imsalmankhalid/CNC_Project/hat_v1/hat3.png

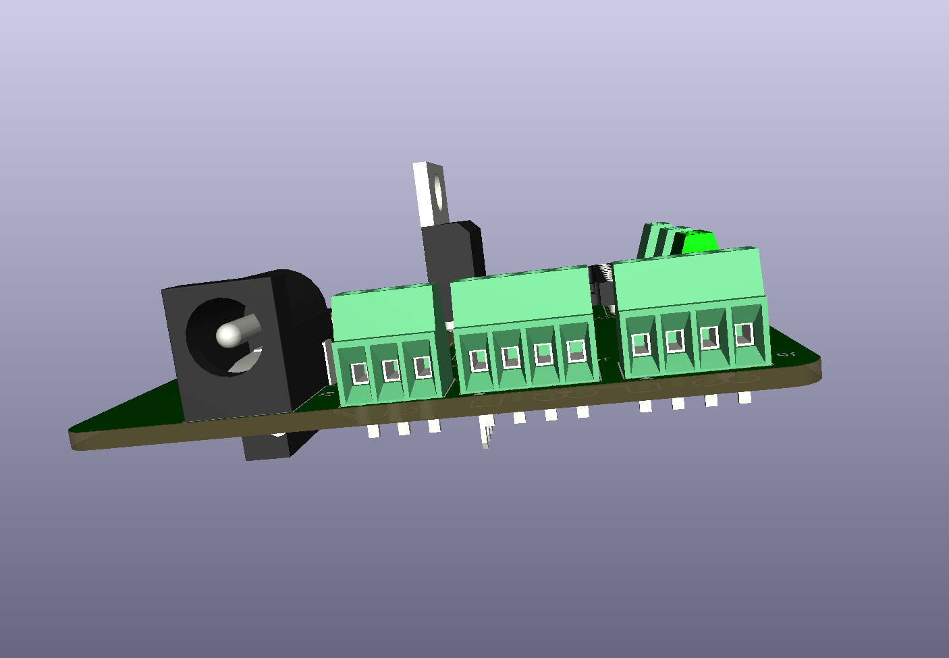
hat_v1/hat3.png
