imsalmankhalid/CNC_Project/hat_v1/hat2.png

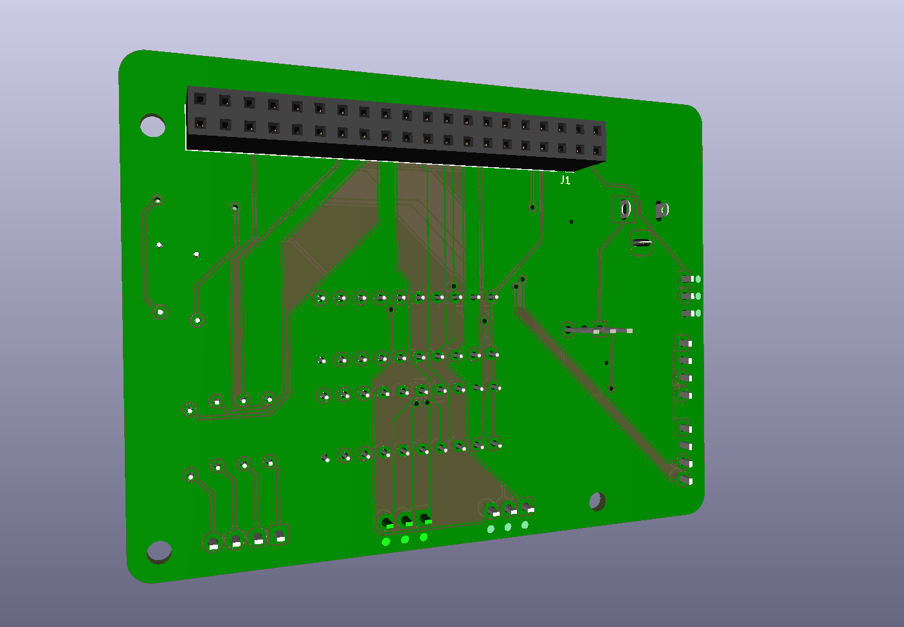
hat_v1/hat2.png
