imsalmankhalid/CNC_Project/lathe_rpi/MP2307DN_Schematic.html

# MP2307DN – 12V to 5V Fixed Buck Regulator

Complete pin-by-pin schematic with all external components · SOP-8 package · 3A output

VIN_12V (12V)

SW (switch node)

5V0_BUCK (5V out)

GND

3V3 (enable)

BOOT

RT/CT → GND

FB → GND (fixed 5V)

VIN 12V Input

3V3 Enable Source

C1 10µF 16V

U3 MP2307DN-5.0 SOP-8

Pin 1 VIN← VIN_12V

Pin 2 EN← 3V3 via R7

Pin 3 SW→ SW node

Pin 4 GND→ GND

Pin 5 BOOT→ C11 → SW

Pin 6 RT/CT→ R24 → GND

Pin 7 FB→ GND (fixed)

Pin 8 GND→ GND

R7 100kΩ

L1 10µH Shielded

D9 SS34 Schottky (SMA)

C11 100nF

R24 22kΩ

C9 22µF 16V

C10 100nF 16V

OUT 5V

📋 External Components (7 total)
L1 10µH shielded inductor (6030 SMD)
D9 SS34 Schottky diode (SMA)
C1 10µF 16V input cap (0805)
C9 22µF 16V output cap (1206)
C10 100nF 16V output decoupling (0805)
C11 100nF bootstrap cap (0805)
R7 100kΩ EN pull-up (0805)
R24 22kΩ frequency-set (0805)

⚡ Key Specifications
Input: 4.75V – 23V (12V nominal)
Output: 5.0V fixed (±1%)
Max current: 3.0A
Frequency: ~550kHz (R24=22kΩ)
Efficiency: ~88% at 12V→5V/2A
Quiescent current: 1.2mA
Shutdown current: 0.1µA (EN=GND)

🔧 Pin Function Notes
VIN — Unregulated 12V input (after fuse)
EN — Enable: HIGH=on, LOW=shutdown. Tie to 3V3 via 100kΩ.
SW — Switch node: connects to inductor. NOISY — keep trace short!
BOOT — Bootstrap: 100nF cap between BOOT and SW.
RT/CT — Timing resistor to GND sets switching frequency.
FB — Feedback: tied to GND for fixed 5V output.
GND — Pins 4 & 8: connect to solid GND plane.

Wire Colors

12V Input

SW / BOOT

5V Output

3V3 Enable

GND
