imsalmankhalid/CNC_Project/lathe_rpi/PCB_Full_Schematic.html

# MbW Lathe HAT – Full Schematic with Wired Connections

## Net Connection Table

Net Name | Color | Connected Components | Pin Count
3V3 | #3fb950 | U2(9 AVDD), R11(2), R4(2), R10(2), R18(2), U2(5 DVDD), U3(2 EN), R12(2), R17(2), R22(2), R1(2), R3(2), J3(1 VCC), D14(Cathode), D15(Cathode), R23(2), R14(2), C6(+), R2(2), C2(1), C3(1), R15(2), J2(1 VCC), C4(+), R16(2) | 25
3V3_REG | #7ee787 | C14(1), D14(Anode), U4(4 VOUT), C13(+) | 4
3V3_RPi | #3fb950 | D15(Anode) | 1
5V0 | #f0883e | U1(11 DIR), C5(+), D11(Cathode), C1(1), J6(1 5V), J4(6 5V), D12(Cathode), U1(20 VCC), J7(1), J5(6 5V) | 10
5V0_BUCK | #ffa657 | D11(Anode), C9(+), C10(1), L1(2), D9(Cathode) | 5
5V0_RPi | #f0883e | D12(Anode) | 1
BOOT_5V | #ffa657 | C11(1), U3(5 BOOT) | 2
BTN1_IN | #79c0ff | R10(1), J8(1) | 2
BTN2_IN | #79c0ff | R11(1), J9(1) | 2
BTN3_IN | #79c0ff | R12(1), J10(1) | 2
ESTOP_COM | #8b949e | J16(3 COM) | 1
ESTOP_IN | #79c0ff | R20(2), J16(2 NO), R18(1), LED2(Anode), R20(1) | 5
ESTOP_NC | #f0883e | J16(1 NC) | 1
HALF_NUT_IN | #79c0ff | J11(1), R13(1) | 2
I2C_SCL | #d2a8ff | U2(2 SCL), R23(1) | 2
I2C_SDA | #d2a8ff | U2(1 SDA), R22(1) | 2
LIM_X_MINUS_IN | #79c0ff | J15(1), R17(1) | 2
LIM_X_PLUS_IN | #79c0ff | R16(1), J14(1) | 2
LIM_Z_MINUS_IN | #79c0ff | R15(1), J13(1) | 2
LIM_Z_PLUS_IN | #79c0ff | R14(1), J12(1) | 2
POT_WIPER | #79c0ff | J7(2), R9(1) | 2
POT_WIPER_ADC | #79c0ff | U2(7 AIN0), R9(2) | 2
RT_CT | #8b949e | U3(6 RT/CT), R24(1) | 2
SPINDLE_IN | #79c0ff | R8(1), R7(2) | 2
SPINDLE_RAW | #79c0ff | J6(3 RAW), D7(Signal), R7(1) | 3
SW_5V | #ffa657 | C11(2), L1(1), U3(3 SW), D9(Anode) | 4
VIN_12V | #ff7b72 | C12(+), U4(1 VIN), C7(+), C1(+), R19(1), R19(2), F1(2), D13(Anode), D8(Cathode), C8(1), U3(1 VIN), LED1(Anode) | 12
VIN_12V_RAW | #ff7b72 | J17(Center), D13(Cathode), F1(1) | 3
X_DIR_3V3 | #58a6ff | U1(5 A5) | 1
X_DIR_5V | #58a6ff | J5(2 DIR), U1(16 B5), D5(Signal) | 3
X_ENC_A_IN | #79c0ff | J3(3 A), R3(1) | 2
X_ENC_B_IN | #79c0ff | J3(4 B), R4(1) | 2
X_EN_3V3 | #58a6ff | U1(6 A6) | 1
X_EN_5V | #58a6ff | U1(17 B6), J5(3 EN), D6(Signal) | 3
X_STEP_3V3 | #58a6ff | U1(4 A4) | 1
X_STEP_5V | #58a6ff | U1(15 B4), D4(Signal), R6(1) | 3
X_STEP_SERVO | #58a6ff | J5(1 STEP), R6(2) | 2
Z_DIR_3V3 | #58a6ff | U1(2 A2) | 1
Z_DIR_5V | #58a6ff | J4(2 DIR), D2(Signal), U1(13 B2) | 3
Z_ENC_A_IN | #79c0ff | R1(1), J2(3 A) | 2
Z_ENC_B_IN | #79c0ff | R2(1), J2(4 B) | 2
Z_EN_3V3 | #58a6ff | U1(3 A3) | 1
Z_EN_5V | #58a6ff | J4(3 EN), U1(14 B3), D3(Signal) | 3
Z_STEP_3V3 | #58a6ff | U1(1 A1) | 1
Z_STEP_5V | #58a6ff | R21(1), LED3(Anode), R5(1), D1(Signal), U1(12 B1), R21(2) | 6
Z_STEP_SERVO | #58a6ff | J4(1 STEP), R5(2) | 2

## Design Suggestions & Improvements ### ✅ Already Correct in Current Design 1. **I2C: NO capacitors on SDA/SCL** — This is correct. The 4.7kΩ pull-ups are sufficient. - ADS1015 adds ~5pF input capacitance per line - Short traces (<5cm) add ~100pF trace capacitance - Total bus capacitance well within 400pF I2C spec limit - **Adding caps would SLOW rise time and cause I2C errors at 400kHz** 2. **Decoupling capacitors** — Every IC has 100nF within 2mm of power pins ✓ 3. **Bulk capacitors** — Each power rail has 10µF bulk cap ✓ 4. **Regulator caps** — Per datasheet requirements ✓ ### 🔧 Suggested Improvements #### 1. I2C Ferrite Bead (Recommended for Industrial Environment) - **Add**: FB1 = 600Ω ferrite bead (0805) on I2C_SDA between RPi and ADS1015 - **Why**: Lathe environment has motor noise. Ferrite bead filters high-frequency noise without slowing I2C. - **Placement**: Between R22 (pull-up) and ADS1015 SDA pin - **Part**: Murata BLM21PG601SN1D (600Ω @ 100MHz, 0805) - **Cap after bead**: C15 = 22pF from filtered SDA to GND (absorbs HF noise) - **Same for SCL**: FB2 + C16 = 22pF #### 2. Encoder Input Protection (Recommended) - **Add**: TVS diodes on encoder lines (Z_ENC_A/B, X_ENC_A/B) - **Why**: Encoder cables run through noisy lathe environment - **Part**: PESD5V0S1UL (same as servo signals) - **Designators**: D16-D19 (one per encoder line) #### 3. Power Rail Ferrite Beads (Optional) - **Add**: FB3 on 5V0 rail near servo connectors (filters motor noise from feeding back) - **Add**: FB4 on 3V3 rail near ADC (cleaner analog supply) - **Part**: Murata BLM21PG121SN1D (120Ω @ 100MHz) #### 4. Spindle Signal Schmitt Trigger (Recommended) - **Add**: 74HC14 Schmitt trigger on SPINDLE_IN line - **Why**: Spindle index signal may have slow rise time from voltage divider - **Alternative**: Add RC filter (100Ω + 100pF) before GPIO pin #### 5. E-Stop NC Trace Width (Critical) - **Current**: ESTOP_NC trace breaks servo ENABLE - **Suggestion**: Use 2mm wide trace for ESTOP_NC path (mechanical reliability) - **Add**: Red silkscreen overlay on ESTOP_NC trace for visual inspection #### 6. Ground Plane Stitching - **Add**: Via every 10mm around board perimeter (connects top/bottom GND) - **Add**: Via near every decoupling capacitor (low-indistance GND return) #### 7. Test Points (Recommended for Debugging) - **Add**: TP1 = 5V0 rail, TP2 = 3V3 rail, TP3 = VIN_12V - **Add**: TP4 = I2C_SDA, TP5 = I2C_SCL (for oscilloscope probing) - **Part**: TestPad_SMD:TestPad_1.0x1.0mm #### 8. Boot/Configuration Jumpers (Optional) - **Add**: JP1 = I2C pull-up enable/disable (for debugging with external pull-ups) - **Add**: JP2 = Encoder pull-up enable/disable #### 9. Thermal Relief for SOT-223 (AP2112) - **Current**: Thermal pad connected to GND - **Suggestion**: Use thermal relief pads (not solid connection) for easier soldering - **Via count**: 3 vias under thermal pad to inner GND plane #### 10. Component Orientation Markers - **Add**: Pin 1 indicator dots on all IC footprints - **Add**: Diode cathode band markers (white silkscreen line) - **Add**: LED polarity markers (+/-) ### ⚠️ Things to Verify Before Fabrication 1. **MP2307 EN pin**: Currently tied to 3V3. Verify this works when 12V is absent (RPi back-feeds 3V3). - If 3V3 rail is powered by RPi back-feed, EN will be HIGH → buck tries to start → but no 12V input → no harm, just idle. - **Safe**: Buck won't output without VIN, so this is fine. 2. **74HC245 3.3V input threshold**: V_IH_min = 0.6 × 5V = 3.0V. RPi outputs 3.3V. - **Margin**: Only 0.3V above threshold. Works in practice but tight. - **Alternative**: Use 74HCT245 (T-series, V_IH = 2.0V at 5V) for better margin. - **Recommendation**: Stick with 74HC245 (already validated in Arduino design). If issues arise, switch to 74HCT245. 3. **Diode OR-ing power loss**: SS34 forward drop ~0.3V at typical current. - 5V rail: 5.0V - 0.3V = 4.7V at load (still within 5V tolerance) - 3.3V rail: 3.3V - 0.3V = 3.0V at load (within 3.3V ±5% = 3.135V minimum) - **WARNING**: 3.0V is BELOW 3.3V -5% tolerance! Consider using lower-drop Schottky (MBR0520T, Vf=0.2V) or ideal diode controller. - **Mitigation**: If using 12V always, this is fine (buck/LDO outputs are clean). Only matters in USB-C-only mode. 4. **Capacitor voltage ratings**: Verify all caps have adequate voltage rating. - C13 (10µF on 3V3_REG): 6.3V rating → OK (3.3V < 6.3V) - C9 (22µF on 5V0_BUCK): 16V rating → OK (5V < 16V) - C7 (10µF on VIN_12V): 25V rating → OK (12V < 25V) 5. **Inductor current rating**: L1 (10µH) should handle MP2307 peak current (~3.5A). - Verify inductor saturation current > 3.5A (Taiyo Yuden GQH101010T: 2.1A saturation) - **POTENTIAL ISSUE**: GQH101010T may saturate at high load. Consider COILCRAFT SSD1050 (3.2A sat) or similar.
