imsalmankhalid/CNC_Project/lathe_rpi/PCB_Full_Schematic_Clean.html

# MbW Lathe HAT – Complete Schematic

12V DC jack + RPi native USB-C · 74HC245 level shifting · ADS1015 ADC · All components placed with wired connections

⚡ Power Input & Protection

🔋 MP2307 Buck 12V→5V

🔋 AP2112 LDO 12V→3.3V

🔗 Diode OR-ing

🔄 74HC245 Level Shifter

📊 ADS1015 ADC + I2C

🔌 Servo Connectors

📡 Encoders

⚙ Spindle Index

🔘 Buttons, Limits, E-Stop

J17 DC Jack 12V

Tip12V

SleeveGND

F1 1A Fuse

D8 TVS

C7 10µF

C8 100nF

U3 MP2307DN Buck

1 VINVIN_12V

2 EN3V3

3 SWSW

4,8 GNDGND

5 BOOTBOOT

6 RT22kΩ→GND

7 FBGND

L1 10µH

D9 SS34

C9 22µF

C10 100nF

C11 100nF

R24 22kΩ

U4 AP2112K-3.3 LDO

1 VINVIN_12V

2,3 GNDGND

4 VOUT3V3_REG

C12 10µF

C13 10µF

C14 100nF

D11 SS34 Buck→5V0

D12 SS34 RPi→5V0

D14 SS34 LDO→3V3

D15 SS34 RPi→3V3

C5 10µF

C6 10µF

U1 74HC245PW Level Shifter (A→B)

1 A1Z_STEP_3V312 B1Z_STEP_5V

2 A2Z_DIR_3V313 B2Z_DIR_5V

3 A3Z_EN_3V314 B3Z_EN_5V

4 A4X_STEP_3V315 B4X_STEP_5V

5 A5X_DIR_3V316 B5X_DIR_5V

6 A6X_EN_3V317 B6X_EN_5V

9 GNDGND20 VCC5V0

10 /CEGND11 DIR5V0

C1 100nF

R5 100Ω

R6 100Ω

J4 Z Servo (Molex-8)

1STEP

2DIR

3EN

5GND

65V0

J5 X Servo (Molex-8)

1STEP

2DIR

3EN

5GND

65V0

D1 TVS

D2 TVS

D3 TVS

D4 TVS

D5 TVS

D6 TVS

U2 ADS1015 ADC

1 SDAI2C_SDA

2 SCLI2C_SCL

3 A0GND

4 GNDGND

5 DVDD3V3

7 AIN0POT

9 AVDD3V3

R22 4.7kΩ

R23 4.7kΩ

C2 100nF

C3 100nF

C4 10µF

R9 10kΩ

J7 Pot (JST-3)

15V0

2Wiper

3GND

J2 Z Encoder (JST-6)

13V3

2GND

3A → GPIO5

4B → GPIO6

J3 X Encoder (JST-6)

13V3

2GND

3A → GPIO13

4B → GPIO19

R1 10kΩ

R2 10kΩ

R3 10kΩ

R4 10kΩ

J6 Spindle (JST-3)

15V0

2GND

3RAW

D7 TVS

R7 10kΩ

R8 20kΩ

J8 BTN1 (Screw-2)

1BTN1_IN

2GND

R10 10kΩ

J9 BTN2 (Screw-2)

1BTN2_IN

2GND

R11 10kΩ

J10 BTN3 (Screw-2)

1BTN3_IN

2GND

R12 10kΩ

J11 Half-Nut (Screw-2)

1HALF_NUT

2GND

R13 10kΩ↓

J12 LIM Z+ (Screw-2)

R14 10kΩ

J13 LIM Z- (Screw-2)

R15 10kΩ

J14 LIM X+ (Screw-2)

R16 10kΩ

J15 LIM X- (Screw-2)

R17 10kΩ

J16 E-Stop (Screw-4)

1NC (hard)

2NO (soft)

3COM

4GND

R18 10kΩ

LED1 🟢 12V OK

R19 1kΩ

LED2 🔴 E-Stop

R20 330Ω

LED3 🟡 Step

R21 330Ω

Net Colors

12V / VIN_12V

5V0 / Buck

3V3 / LDO

GPIO Signals

I2C / Inputs

GND

## 🔍 Design Review & Suggestions

✅ I2C: NO capacitors on SDA/SCL — This is correct. The 4.7kΩ pull-ups (R22, R23) are sufficient. ADS1015 adds ~5pF input capacitance. Short traces (<5cm) add ~100pF. Total is well within the 400pF I2C spec limit. Adding caps would slow rise time and cause I2C errors at 400kHz.

✅ Decoupling is correct — Every IC has 100nF within 2mm of power pins. Each rail has 10µF bulk. Regulator caps match datasheet requirements.

### 🔧 Suggested Improvements

### 1. I2C Ferrite Beads (Recommended for Industrial Environment)

- Add: FB1 = 600Ω ferrite bead (0805) on I2C_SDA between RPi and ADS1015
- Why: Lathe environment has motor noise. Ferrite bead filters HF noise without slowing I2C.
- Part: Murata BLM21PG601SN1D (600Ω @ 100MHz, 0805)
- Placement: Between R22 (pull-up) and ADS1015 SDA pin
- Cap after bead: C15 = 22pF from filtered SDA to GND
- Same for SCL: FB2 + C16 = 22pF

### 2. Encoder Input Protection (Recommended)

- Add: TVS diodes on encoder lines (Z_ENC_A/B, X_ENC_A/B)
- Why: Encoder cables run through noisy lathe environment
- Part: PESD5V0S1UL (same as servo signals D1-D6)
- Designators: D16-D19 (one per encoder line)

### 3. Spindle Signal Schmitt Trigger (Recommended)

- Add: 74HC14 Schmitt trigger on SPINDLE_IN line
- Why: Spindle index signal may have slow rise time from voltage divider
- Alternative: Add RC filter (100Ω + 100pF) before GPIO pin

### 4. Test Points (Recommended for Debugging)

- Add: TP1 = 5V0 rail, TP2 = 3V3 rail, TP3 = VIN_12V
- Add: TP4 = I2C_SDA, TP5 = I2C_SCL (for oscilloscope probing)
- Part: TestPad_SMD:TestPad_1.0x1.0mm

### 5. Ground Plane Stitching

- Add: Via every 10mm around board perimeter (connects top/bottom GND)
- Add: Via near every decoupling capacitor (low-inductance GND return)

### 6. E-Stop NC Trace Width (Critical)

- Use: 2mm wide trace for ESTOP_NC path (mechanical reliability)
- Add: Red silkscreen overlay on ESTOP_NC trace for visual inspection

⚠️ WARNING: 3.3V Rail Diode Drop
SS34 forward drop ~0.3V. In USB-C-only mode: 3.3V - 0.3V = 3.0V at load.
This is BELOW 3.3V -5% tolerance (3.135V minimum)!
Mitigation: If using 12V always, this is fine. For USB-C-only mode, consider MBR0520T (Vf=0.2V) or ideal diode controller.

⚠️ Inductor Saturation Check
GQH101010T has 2.1A saturation current. MP2307 peak current can reach ~3.5A.
Recommendation: Use COILCRAFT SSD1050 (3.2A sat) or similar higher-current inductor.

### 7. 74HC245 Input Margin

- V_IH_min = 0.6 × 5V = 3.0V. RPi outputs 3.3V. Margin = 0.3V (tight but works).
- Alternative: 74HCT245 (T-series, V_IH = 2.0V at 5V) for better margin.
- Recommendation: Stick with 74HC245 (validated in Arduino design). Switch to 74HCT245 only if issues arise.

### 8. Component Orientation Markers

- Pin 1 indicator dots on all IC footprints
- Diode cathode band markers (white silkscreen line)
- LED polarity markers (+/-)
