imsalmankhalid/CNC_Project/lathe_rpi/PCB_Schematic.html

# MbW Lathe HAT – Pin Connection Schematic

12V DC jack on HAT · RPi native USB-C · 74HC245 level shifting · ADS1015 ADC

3.3V

5.0V

12V

GND

Signal (3.3V→5V)

I2C

Input

⚡ Power 🔄 74HC245 📊 ADS1015 🔌 GPIO Map 🔗 Connectors

## Power Architecture – 12V Input → Buck + LDO → OR-ing → RPi

J17 DC Jack – 12V Input (2.1mm Barrel)

Input Protection – Fuse, TVS, Capacitors

U3 MP2307DN – Buck Regulator 12V→5V Fixed (SOP-8)

U4 AP2112K-3.3 – LDO Regulator 12V→3.3V (SOT-223)

Diode OR-ing – Buck + LDO + RPi Back-feed → 5V0 / 3V3 Rails

Power Flow Summary – Two Operating Modes

## 74HC245 Level Shifter – Pin-by-Pin (TSSOP-20)

74HC245PW (U1) – TSSOP-20

## ADS1015 ADC – Pin-by-Pin (VSSOP-10, 3×3 mm)

ADS1015IDGSR (U2) – VSSOP-10

## Raspberry Pi 40-Pin GPIO – Complete Pin Map

RPi GPIO Header (J1) – 2×20 Male

## All External Connectors – Pinout Reference

### J2 – Z Encoder (JST PH 6-pin)

1 | 3V3 | VCC
2 | GND | Ground
3 | Z_ENC_A | → GPIO 5
4 | Z_ENC_B | → GPIO 6
5 | — | INDEX (NC)
6 | — | NC

### J3 – X Encoder (JST PH 6-pin)

1 | 3V3 | VCC
2 | GND | Ground
3 | X_ENC_A | → GPIO 13
4 | X_ENC_B | → GPIO 19
5 | — | INDEX (NC)
6 | — | NC

### J4 – Z Servo (Molex 8-pin)

1 | Z_STEP_5V | ← 74HC245 B1 +100Ω
2 | Z_DIR_5V | ← 74HC245 B2 +100Ω
3 | Z_EN_5V | ← 74HC245 B3
4 | — | HLFB (NC)
5 | GND | Signal ground
6 | 5V0 | Logic power
7 | — | HV+ (external 70V)
8 | — | HV- (external 70V)

### J5 – X Servo (Molex 8-pin)

1 | X_STEP_5V | ← 74HC245 B4 +100Ω
2 | X_DIR_5V | ← 74HC245 B5 +100Ω
3 | X_EN_5V | ← 74HC245 B6
4 | — | HLFB (NC)
5 | GND | Signal ground
6 | 5V0 | Logic power
7 | — | HV+ (external 70V)
8 | — | HV- (external 70V)

### J6 – Spindle Index (JST PH 3-pin)

1 | 5V0 | → AutoTech C3 +5V
2 | GND | Common ground
3 | SPINDLE_RAW | → 10k/20k divider → GPIO 12

### J7 – Potentiometer (JST PH 3-pin)

1 | 5V0 | Pot end A (5V)
2 | POT_WIPER | → 10kΩ → ADS1015 AIN0
3 | GND | Pot end B

### J8/J9/J10 – Buttons (2-pin screw)

1 | BTN_IN | → GPIO + 10kΩ pull-up 3V3
2 | GND | Switch closes to GND

J8→GPIO26 | J9→GPIO20 | J10→GPIO21

### J11 – Half-Nut (2-pin screw)

1 | HALF_NUT_IN | → GPIO 4 + 10kΩ pull-down
2 | GND | Ground

### J12–J15 – Limit Switches (2-pin screw)

1 | LIM_IN | → GPIO + 10kΩ pull-up 3V3
2 | GND | NC switch to GND

J12→GPIO16(Z+) | J13→GPIO7(Z-) | J14→GPIO8(X+) | J15→GPIO11(X-)

### J16 – E-Stop (4-pin screw)

1 | ESTOP_NC | Hard-wired to ENABLE traces
2 | ESTOP_NO | → GPIO + 10kΩ pull-up
3 | ESTOP_COM | Common terminal
4 | GND | Ground

### J17 – 12V DC Input (Barrel Jack)

Tip | VIN_12V | → Fuse → Buck + LDO
Sleeve | GND | Common ground

5.5mm × 2.1mm, center-positive
