imsalmankhalid/CNC_Project/Arduino Mega MbW Scope of Work .docx

Arduino Mega Upgrade

Update: 7/29/2025, 12/26/25

Background

The current system has a dual purpose. It allows for manual and CNC operation. The CNC operation seems to be working well,

The manual system uses an Arduino MEGA and is limited in speed / performance.

There is two encoders CUI AMT 103-V that are used to generate the signal to drive the axis when the hand wheels are rotated. (See CUI AMT 103 manual)

There is a barrel switch to power the Arduino and the ESS (on/off) for the Mach3 CNC option.

Limit switches are needed to stop the machine from traveling too far, there will be four switches (x+,x- and z+, z-)

Once the switch is triggered the axis will have to be backed up to release the switch. Maybe a push button, There are two scenarios if the servo motors remain active then you can just rotate the hand wheels. The motor is deactivated with the switch then you need to reset to activate the motors then back off the switch.

I am not sure what is the best solution. Current system does not have limit switches.

When the half nut is engaged the Z+ axis will move in the positive direction and is adjustable with a 10K pot for speed. I would like to also move it in the Z- direction with a direction switch. It will move until it hits a limit switch.

There are 4 videos that show the project in detail on Youtube.

CNC Lathe Conversion overview, Grizzly G0602 G0752, WITH manual controls (1 of 4) (https://www.youtube.com/watch?v=1rEC3S5HFY8&t=116s)

The system does function ok, but it needs to be upgraded.

Functional Capabilities of the Arduino System

Scope:

1. Convert the system into real-time dual processor, Beaglebone, EPS32 or other.

Issue to be addressed: If the X and Z axis hand wheels are rotated at the same time then the LED screen does not keep up.

2. System needs limit switches (X+,X- and Z+, Z-) this probably needs to be a NO switch x 4

Operation when the switch is presses the machine stops, need a solution to get the machine servos to back off the switch. Maybe they can back up but not forward.

3. HalfNut - there should be an option to switch direction (Z+ or Z-) for the half nut engagement.
4. LCD screen upgraded to color, maybe a touch screen, larger screen would be better. Also, the screen should display a standard clock to show current time. The clock is optional. A larger screen is preferred. Maybe 4 x 6 Color touch screen for inputs etc.

Documentation:

1. Detailed wiring diagram of the new system showing all connections and configurations.
2. Document the software code changes as needed,
3. Operating instructions

Testing

The system must be thoroughly tested and debugged. The board, encoders and color LCD must be purchased and included in the package. (cost will be reimbursed)

A bench testing setup will probably be the best solution.

Necessary updates will be provided for the first six months.

Deliverables

1. Working system that matches the Mega functionality everything must work the same.
2. The upgrades are listed in the scope above.
3. Full operational system that has been debugged
4. Documentation

Proprietary

The code is owned by the original maker; I have permission to update the system for my own use only. The code is not to be distributed or sold in any way.
