imsalmankhalid/CNC_Project/hat/hat2.png

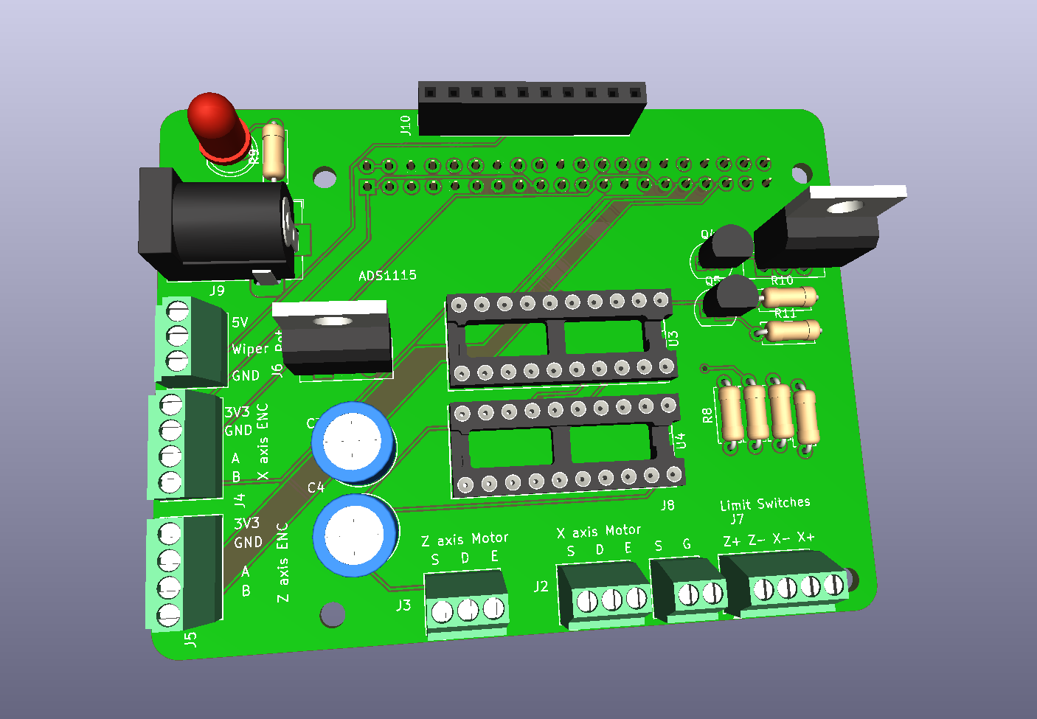
hat/hat2.png
