imsalmankhalid/CNC_Project/hat/hat.png

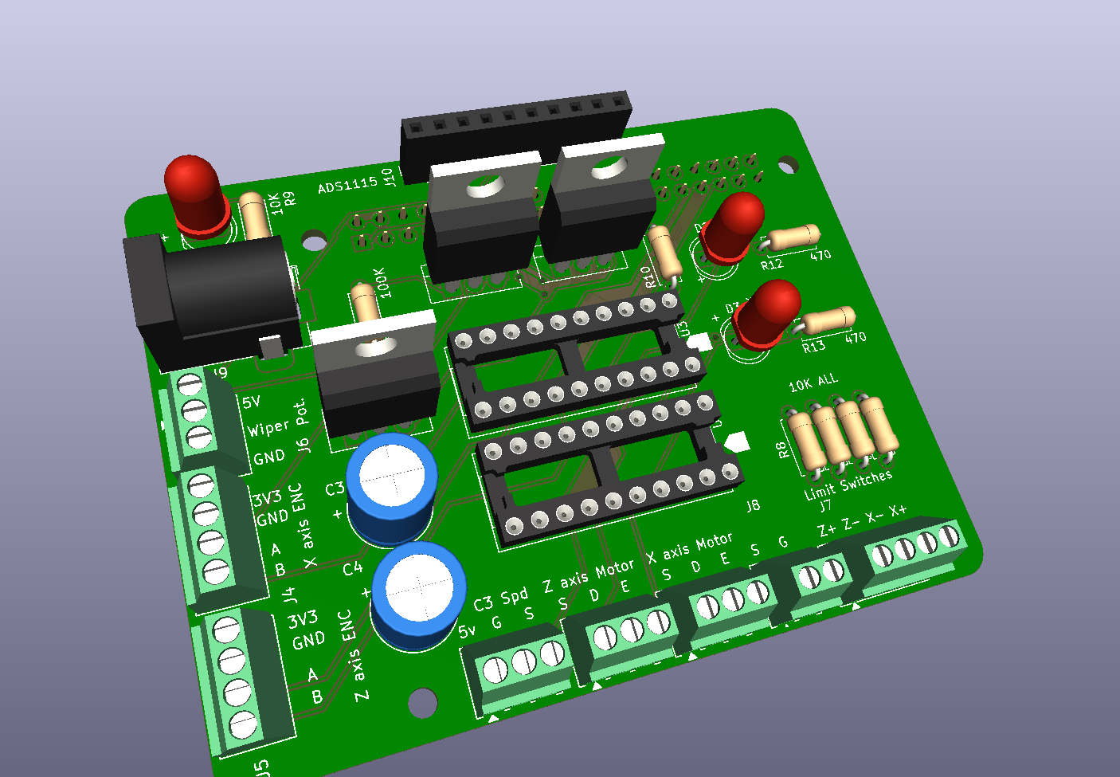
hat/hat.png
