imsalmankhalid/CNC_Project/hat_v1/hat4.png

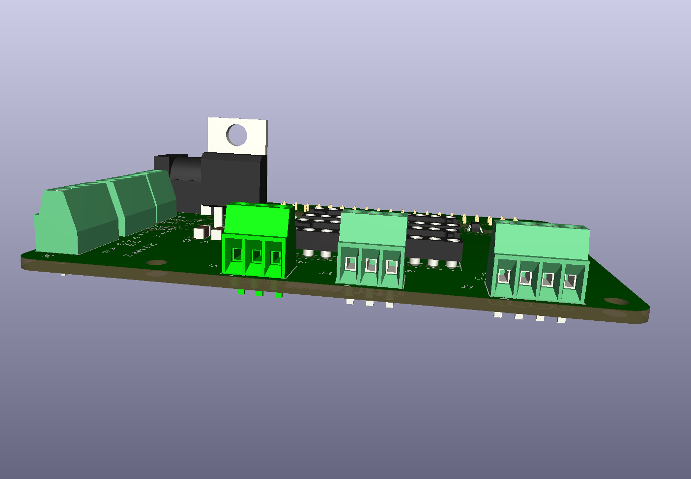
hat_v1/hat4.png
