imsalmankhalid/CNC_Project/hat_v1/hat5.png

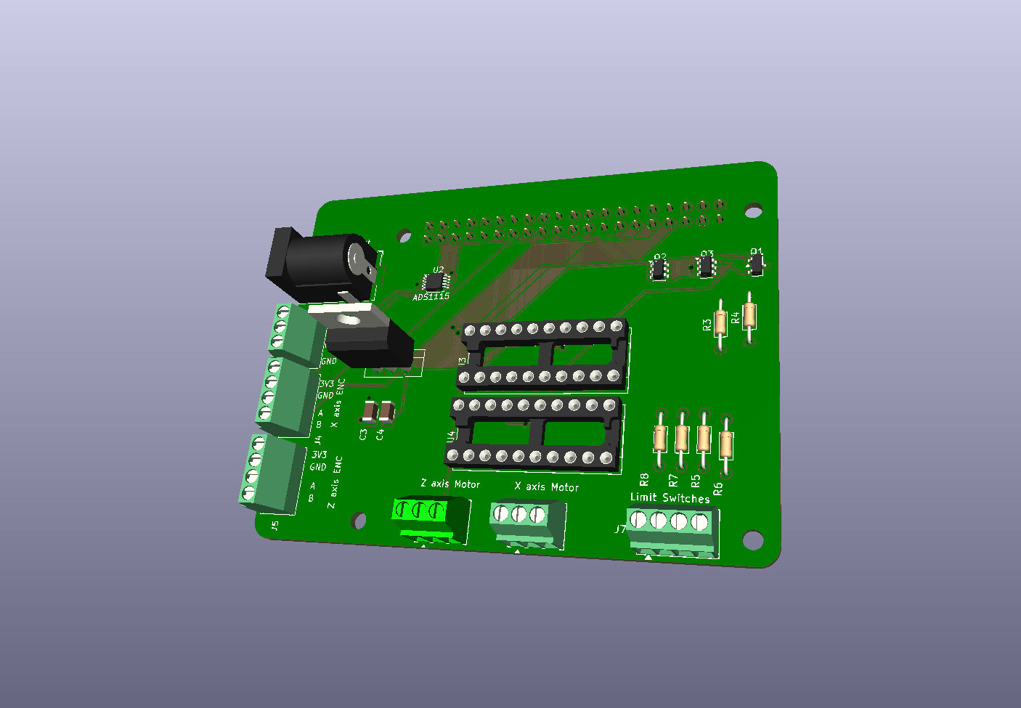
hat_v1/hat5.png
