imsalmankhalid/CNC_Project/hat_v1/hat.png

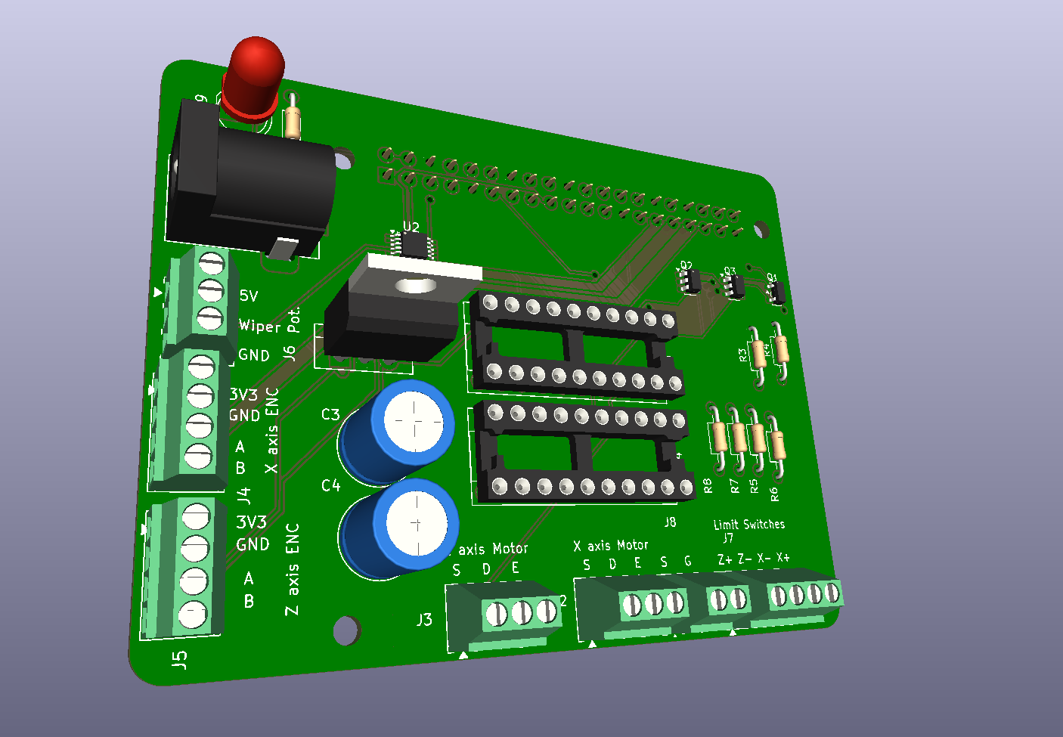
hat_v1/hat.png
