imsalmankhalid/CNC_Project/hat_v1/hat.kicad_pcb

## KiCad design hat_v1/hat.kicad_pcb (2026-08-25)

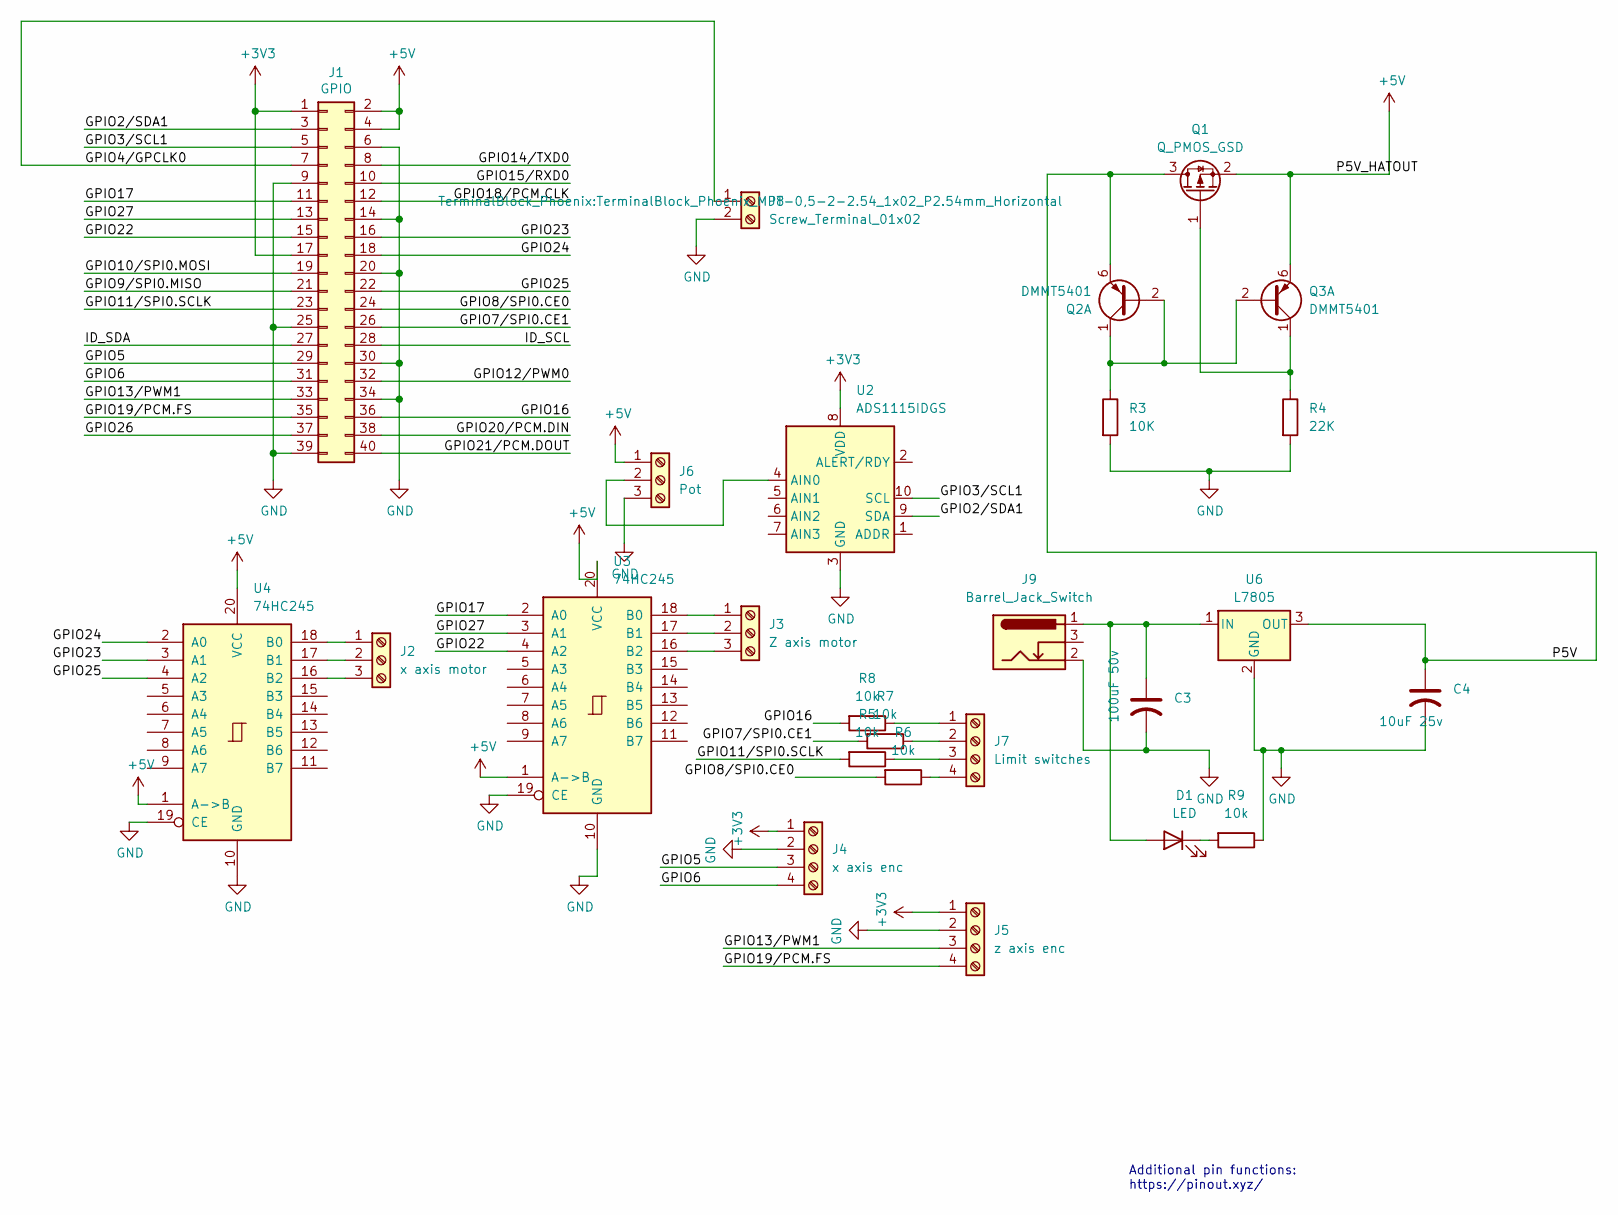
[picture p21: schematic hat.kicad_sch]

Parts:
C3: 100uF 50v; C_Radial_D8.0mm_H11.5mm_P3.50mm
C4: 10uF 25v; C_Radial_D8.0mm_H11.5mm_P3.50mm
D1: LED; LED_D5.0mm
J1: GPIO; PinSocket_2x20_P2.54mm_Vertical
J2: x axis motor; TerminalBlock_Phoenix_MPT-0,5-3-2.54_1x03_P2.54mm_Horizontal
J3: Z axis motor; TerminalBlock_Phoenix_MPT-0,5-3-2.54_1x03_P2.54mm_Horizontal
J4: x axis enc; TerminalBlock_Phoenix_MPT-0,5-4-2.54_1x04_P2.54mm_Horizontal
J5: z axis enc; TerminalBlock_Phoenix_MPT-0,5-4-2.54_1x04_P2.54mm_Horizontal
J6: Pot; TerminalBlock_Phoenix_MPT-0,5-3-2.54_1x03_P2.54mm_Horizontal
J7: Limit switches; TerminalBlock_Phoenix_MPT-0,5-4-2.54_1x04_P2.54mm_Horizontal
J8: Screw_Terminal_01x02; TerminalBlock_Phoenix_MPT-0,5-2-2.54_1x02_P2.54mm_Horizontal
J9: Barrel_Jack_Switch; BarrelJack_Horizontal
Q1: Q_PMOS_GSD; SOT-23
Q2, Q3: DMMT5401; SOT-23-6
R3: 10K; R_Axial_DIN0204_L3.6mm_D1.6mm_P7.62mm_Horizontal
R4: 22K; R_Axial_DIN0204_L3.6mm_D1.6mm_P7.62mm_Horizontal
R5, R6, R7, R8, R9: 10k; R_Axial_DIN0204_L3.6mm_D1.6mm_P7.62mm_Horizontal
U2: ADS1115IDGS; TSSOP-10_3x3mm_P0.5mm
U3, U4: 74HC245; DIP-20_W7.62mm_Socket
U6: L7805; TO-220-3_Vertical

Connections:
+3V3: J1.1, J1.17, J4.1, J5.1, U2.8 (VDD)
+5V: J1.2, J1.4, J6.1, Q1.2 (S), Q3.6 (E1), U3.1 (A->B), U3.20 (VCC), U4.1 (A->B), U4.20 (VCC)
/GPIO2/SDA1: J1.3, U2.9 (SDA)
/GPIO3/SCL1: J1.5, U2.10 (SCL)
/GPIO4/GPCLK0: J1.7, J8.1
/GPIO5: J1.29, J4.3
/GPIO6: J1.31, J4.4
/GPIO7/SPI0.CE1: J1.26, R7.2
/GPIO8/SPI0.CE0: J1.24, R6.2
/GPIO9/SPI0.MISO: J1.21
/GPIO10/SPI0.MOSI: J1.19
/GPIO11/SPI0.SCLK: J1.23, R5.2
/GPIO12/PWM0: J1.32
/GPIO13/PWM1: J1.33, J5.3
/GPIO14/TXD0: J1.8
/GPIO15/RXD0: J1.10
/GPIO16: J1.36, R8.2
/GPIO17: J1.11, U3.2 (A0)
/GPIO18/PCM.CLK: J1.12
/GPIO19/PCM.FS: J1.35, J5.4
/GPIO20/PCM.DIN: J1.38
/GPIO21/PCM.DOUT: J1.40
/GPIO22: J1.15, U3.4 (A2)
/GPIO23: J1.16, U4.3 (A1)
/GPIO24: J1.18, U4.2 (A0)
/GPIO25: J1.22, U4.4 (A2)
/GPIO26: J1.37
/GPIO27: J1.13, U3.3 (A1)
/ID_SCL: J1.28
/ID_SDA: J1.27
/P5V: C4.1, Q1.3 (D), Q2.6 (E1), U6.3 (OUT)
GND: C3.2, C4.2, J1.6, J1.9, J1.14, J1.20, J1.25, J1.30, J1.34, J1.39, J4.2, J5.2, J6.3, J8.2, J9.2, R3.2, R4.2, R9.1, U2.3 (GND), U3.10 (GND), U3.19 (CE), U4.10 (GND), U4.19 (CE), U6.2 (GND)
unnamed: C3.1, D1.2 (A), J9.1, U6.1 (IN)
unnamed: D1.1 (K), R9.2
unnamed: J2.1, U4.18 (B0)
unnamed: J2.2, U4.17 (B1)
unnamed: J2.3, U4.16 (B2)
unnamed: J3.1, U3.18 (B0)
unnamed: J3.2, U3.17 (B1)
unnamed: J3.3, U3.16 (B2)
unnamed: J6.2, U2.4 (AIN0)
unnamed: J7.1, R8.1
unnamed: J7.2, R7.1
unnamed: J7.3, R5.1
unnamed: J7.4, R6.1
unnamed: Q1.1 (G), Q3.1 (C1), R4.1
unnamed: Q2.1 (C1), Q2.2 (B1), Q3.2 (B1), R3.1

Notes on the sheet:
Additional pin functions: https://pinout.xyz/

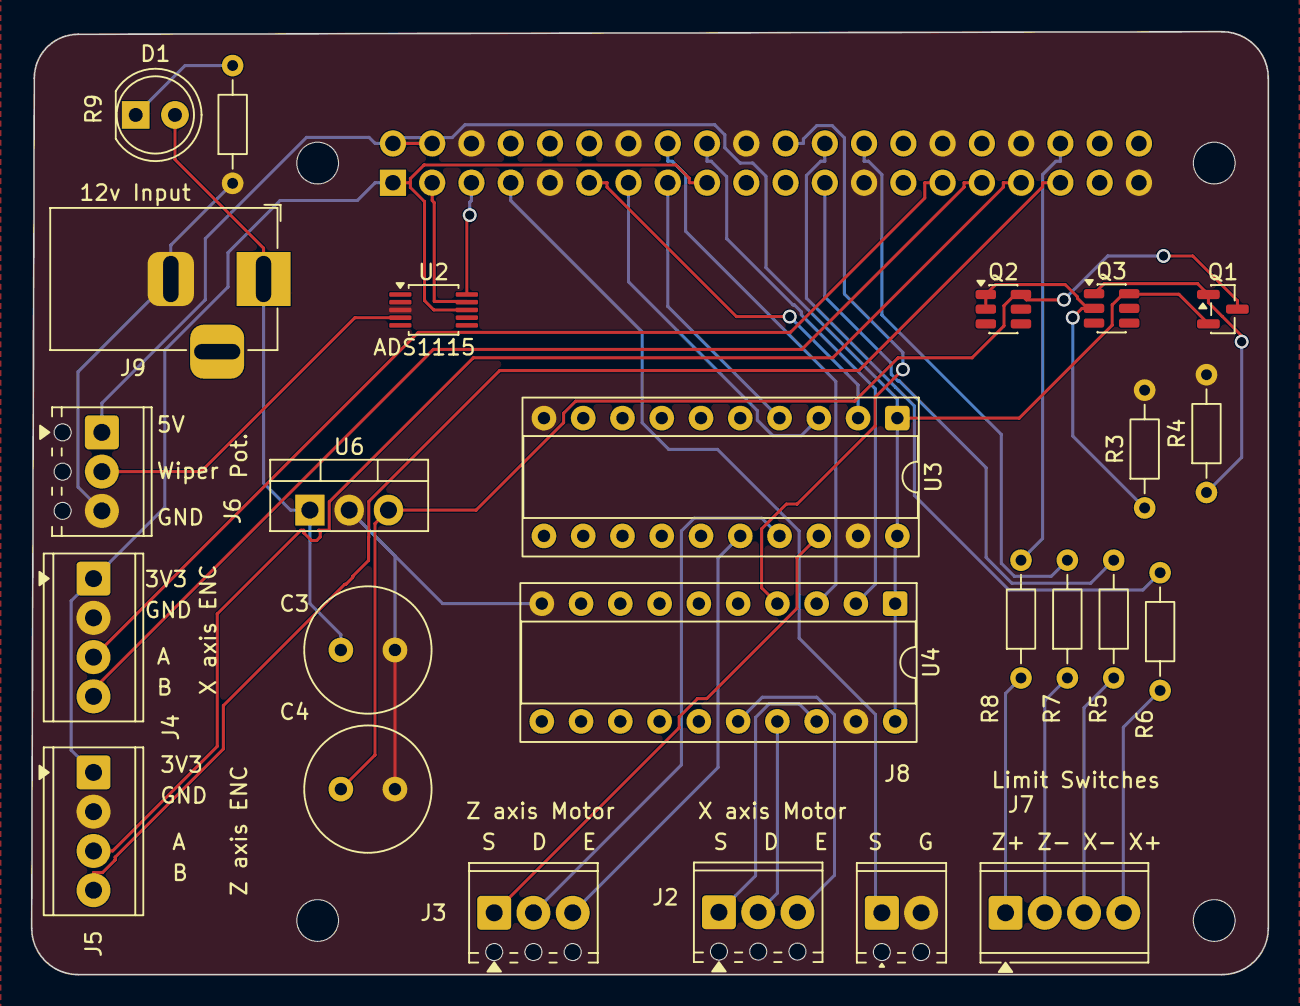
[picture p22: board hat.kicad_pcb from above]

Board: 2 copper layers, 80.0 x 61.0 mm, 30 parts (1 on the bottom side), 36 nets.

Other parts of the board:
MH1, MH2, MH3, MH4: MountingHole_2.7mm_M2.5
