imsalmankhalid/CNC_Project/(commit log)

2026-07-25 Bench-test HAL: X axis working; Z working with limits disabled
    - Sync Pi5 HAL to validated enc_drive_motor.py (pins, ADS1015, lgpio, timing)
    - Fix X STEP/DIR pin swap in config.py (STEP=24, DIR=23)
    - Add configurable console+file logging (log_setup.py) with debug flag
    - Add LIMITS_ENABLED flag: a stuck Z+ limit was blocking all +Z motion;
    disable limits for bench testing so Z jogs both directions
    - Remove cross-axis encoder freeze/restore so Z and X jog simultaneously
    - UI: fix fullscreen button-bar overlap, add EXIT button + shortcuts
    - Add desktop launcher (MbWLathe.desktop / install_desktop.sh) and testing guide
    [config.py, enc_drive_motor.py, log_setup.py, main.py, motion_controller.py, rpi5_interface.py]
2026-07-25 Z axis: mirror X stepping, omit limits/velocity-banding for bench testing
    Make Z and X jog smoothly and simultaneously on the bench by simplifying
    the Z handwheel path to match X exactly.
    core/motion_controller.py:
    - _process_z_handwheel now uses the same plain ±1-per-encoder-count stepping
    as _process_x_handwheel (gearing still preserved via Z_COUNT_ADJ_INV buffer
    subtraction), keeping the runaway buffer clamp.
    - Temporarily removed from the Z path (NOT deleted): velocity-band step
    batching (Z_VEL_LIMIT_A..D / calc_vel), limit-switch blocking
    (limit_z_plus/minus), and mem_stop_z auto-stop.
    - Preserved the full original Z logic in a clearly-marked comment block inside
    _process_z_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
2026-07-25 Limit switches: per-axis stop + red flashing DRO/banner alarm + beep
    Add a single limit switch per axis (Z=GPIO16, X=GPIO8) with motion blocking
    and clear operator feedback on the display.
    Hardware / config:
    - Document that ONE NO-to-GND switch per axis is fitted: Z on GPIO 16, X on
    GPIO 8 (the existing +limit pins). The minus pins (7/11) are reserved and may
    be left unwired (internal pull-up reads them as not-triggered).
    - Add LIMIT_SOUND toggle (best-effort audible alert).
    State / motion (core):
    - state_manager: add per-axis limit_z / limit_x flags (either direction).
    - motion_controller._check_limits: derive limit_z/limit_x from the switch reads
    (honours LIMITS_ENABLED; all clear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
2026-08-25 Add wiring guide PDF, new PCB schematics and documentation, and script utilities for generating schematics. Also update lathe configuration file with latest hardware parameters.
    [hat-B_Cu.gbl, hat-B_Mask.gbs, hat-B_Silkscreen.gbo, hat-Edge_Cuts.gm1, hat-F_Cu.gtl, hat-F_Mask.gts, hat-F_Silkscreen.gto, hat-NPTH.drl]
2026-08-27 HAT design updated, rev2
    [hat-B_Cu.gbl, hat-B_Mask.gbs, hat-B_Silkscreen.gbo, hat-Edge_Cuts.gm1, hat-F_Cu.gtl, hat-F_Mask.gts, hat-F_Silkscreen.gto, hat-NPTH.drl]
